rudranshgoel1/litezero/prod/pcb/litezero.csv

Id | Designator | Footprint | Quantity | Designation | Supplier and ref
1 | C1, C3, C5, C10, C12, C13 | C_0805_2012Metric_Pad1.18x1.45mm_HandSolder | 6 | 10uF
2 | C2, C4, C6, C8, C9, C11, C14 | C_0805_2012Metric_Pad1.18x1.45mm_HandSolder | 7 | 100nF
3 | C7 | C_0805_2012Metric_Pad1.18x1.45mm_HandSolder | 1 | 22uF
4 | D1 | LED_D5.0mm | 1 | POWER
5 | D2 | LED_D5.0mm | 1 | STATUS
6 | D3, D4 | LED_D5.0mm | 2 | LED
7 | J1 | PinHeader_1x04_P2.54mm_Vertical | 1 | 1.3 inch
8 | J2 | USB_C_Receptacle_HRO_TYPE-C-31-M-12 | 1 | USB_C_Receptacle_USB2.0_14P
9 | J3, J5 | PinHeader_1x03_P2.54mm_Vertical | 2 | Conn_01x03
10 | J4 | PinHeader_2x04_P2.54mm_Vertical | 1 | cc1101
11 | J7 | PinHeader_1x04_P2.54mm_Vertical | 1 | pn532
12 | J8 | PinHeader_1x06_P2.54mm_Vertical | 1 | sd card reader
13 | Q1 | TO-92_Inline | 1 | 2N3904
14 | R1, R2 | R_0805_2012Metric_Pad1.20x1.40mm_HandSolder | 2 | 220ohm
15 | R3 | R_0805_2012Metric_Pad1.20x1.40mm_HandSolder | 1 | 1k ohm
16 | R4, R5 | R_0805_2012Metric_Pad1.20x1.40mm_HandSolder | 2 | 100 ohm
17 | R6, R7 | R_0805_2012Metric_Pad1.20x1.40mm_HandSolder | 2 | 5.1kohm
18 | R10 | R_0805_2012Metric_Pad1.20x1.40mm_HandSolder | 1 | 10 kohm
19 | SW1 | SW_PUSH_6mm | 1 | UP
20 | SW2 | SW_PUSH_6mm | 1 | DOWN
21 | SW3 | SW_PUSH_6mm | 1 | SELECT
22 | U1, U3 | nRF24L01_Breakout | 2 | NRF24L01_Breakout
23 | U2 | SOT-23-5 | 1 | AP2112K-3.3
24 | U4 | Vishay_MINICAST-3Pin | 1 | TSOP382xx
25 | U6 | ESP32-S3-WROOM-1 | 1 | ESP32-S3-WROOM-1
