rudranshgoel1/litezero/images/litezero.pdf

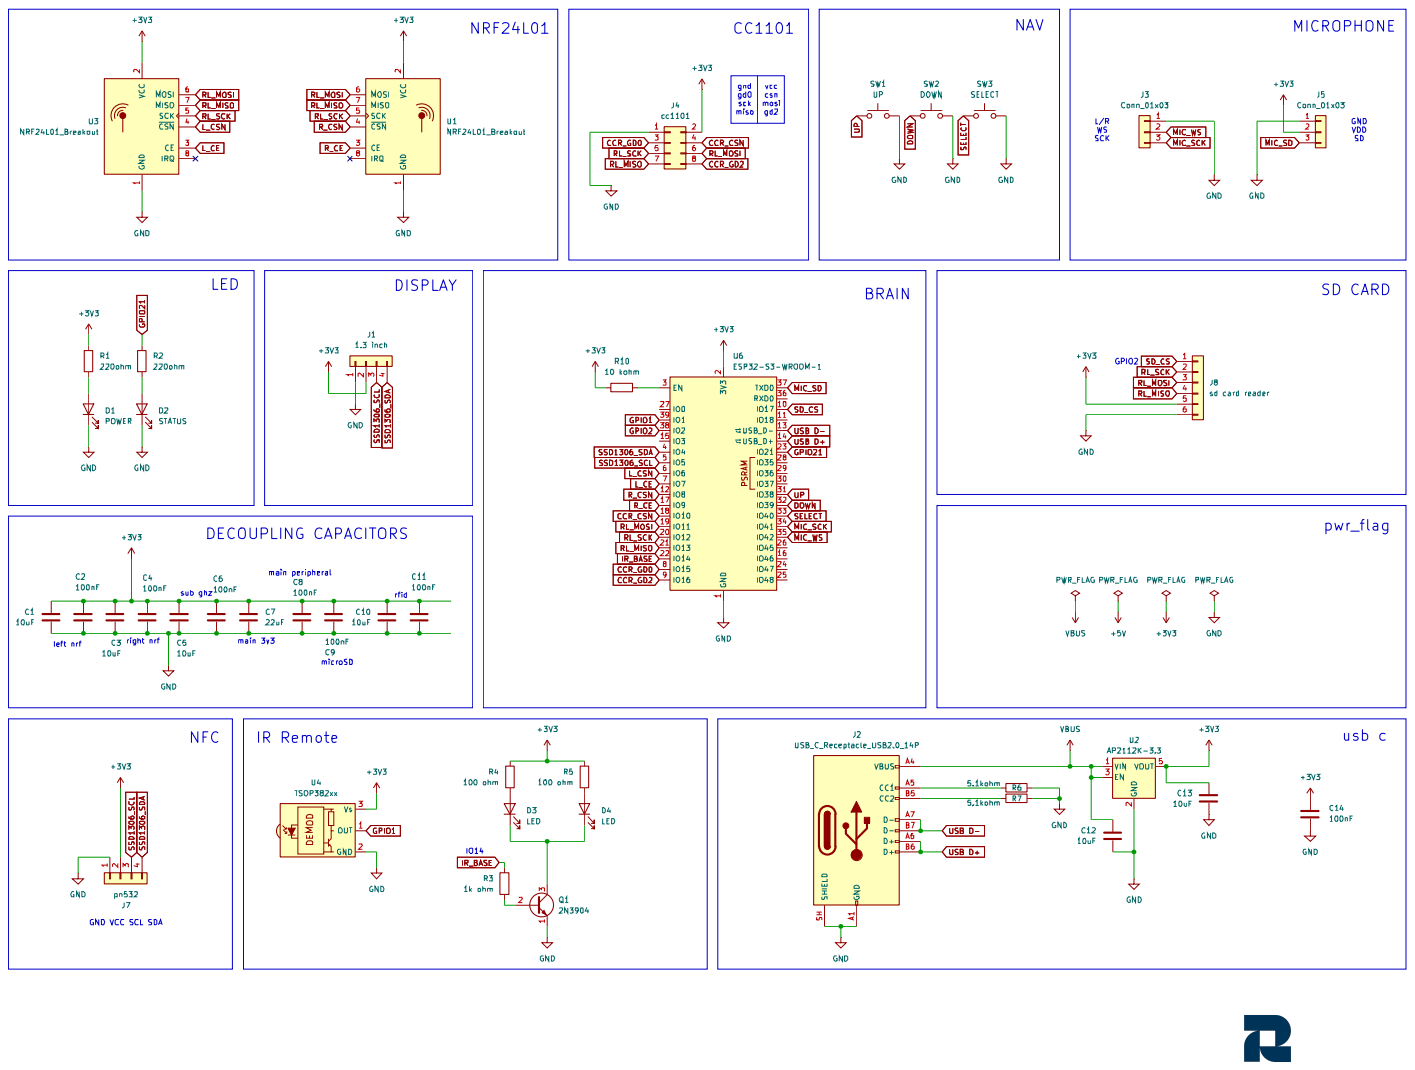
[picture p5: page 1]
