rudranshgoel1/litezero/pcb/litezero.kicad_pcb

## KiCad design pcb/litezero.kicad_pcb (2026-10-13)

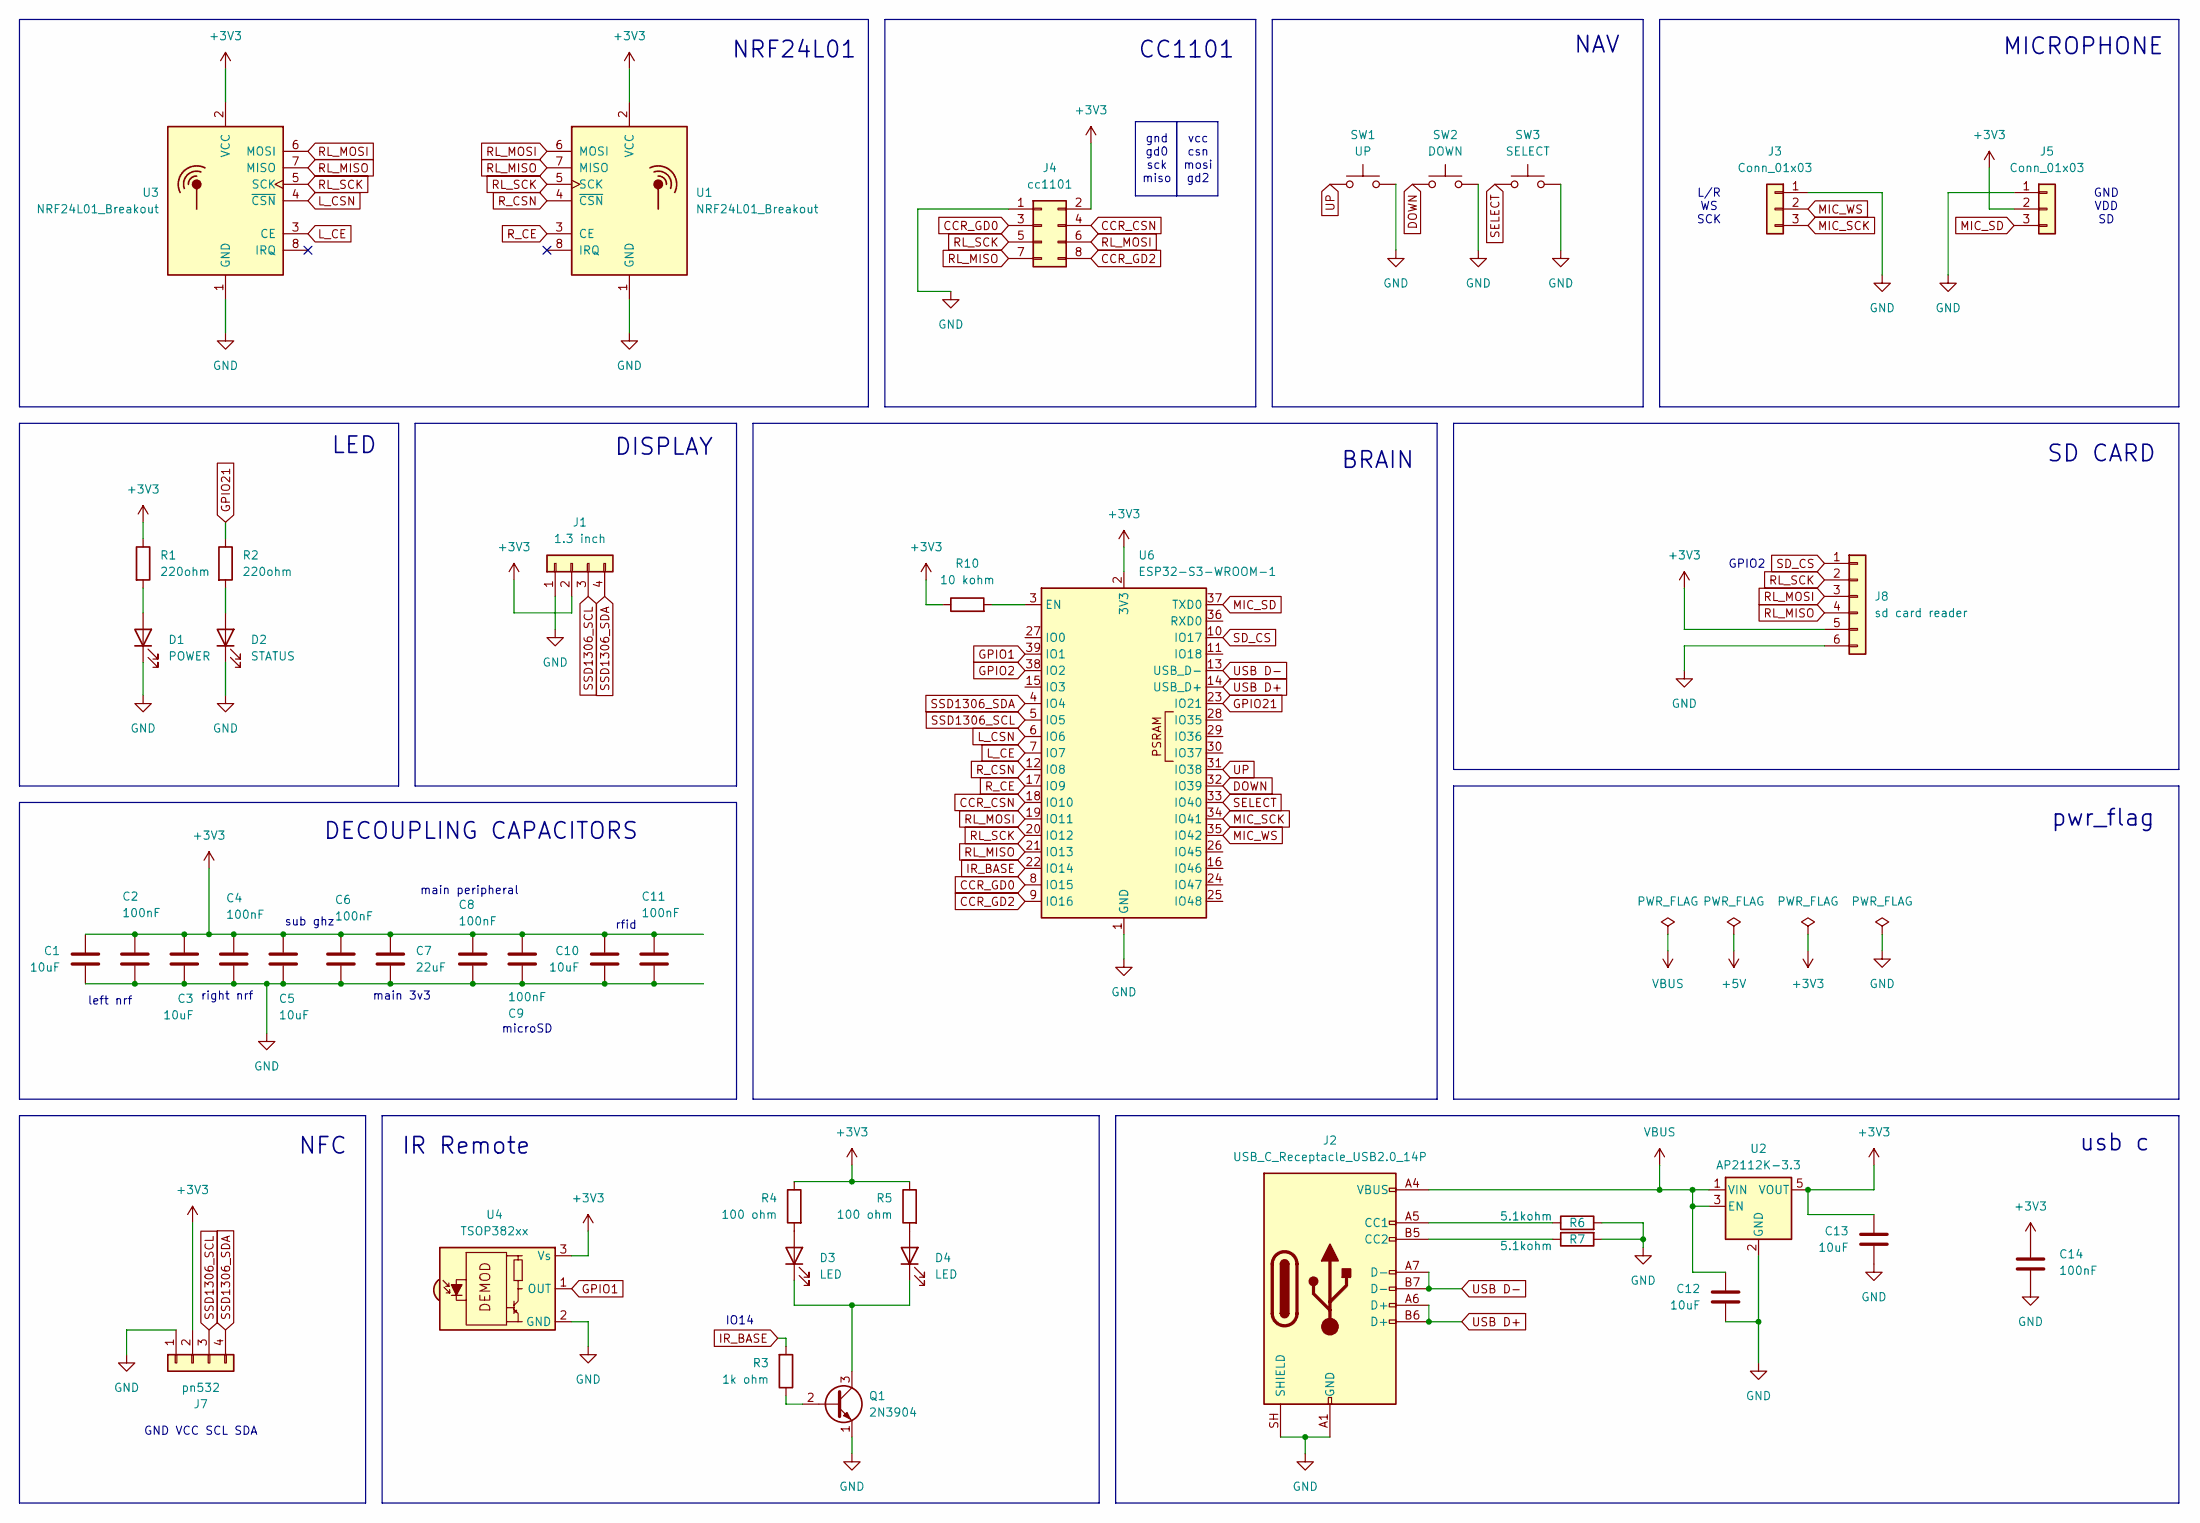
[picture p6: schematic litezero.kicad_sch]

Parts:
C1, C3, C5, C10, C12, C13: 10uF; C_0805_2012Metric_Pad1.18x1.45mm_HandSolder
C2, C4, C6, C8, C9, C11, C14: 100nF; C_0805_2012Metric_Pad1.18x1.45mm_HandSolder
C7: 22uF; C_0805_2012Metric_Pad1.18x1.45mm_HandSolder
D1: POWER; LED_D5.0mm
D2: STATUS; LED_D5.0mm
D3, D4: LED; LED_D5.0mm
J1: 1.3 inch; PinHeader_1x04_P2.54mm_Vertical
J2: USB_C_Receptacle_USB2.0_14P; USB_C_Receptacle_HRO_TYPE-C-31-M-12
J3, J5: Conn_01x03; PinHeader_1x03_P2.54mm_Vertical
J4: cc1101; PinHeader_2x04_P2.54mm_Vertical
J7: pn532; PinHeader_1x04_P2.54mm_Vertical
J8: sd card reader; PinHeader_1x06_P2.54mm_Vertical
Q1: 2N3904; TO-92_Inline
R1, R2: 220ohm; R_0805_2012Metric_Pad1.20x1.40mm_HandSolder
R3: 1k ohm; R_0805_2012Metric_Pad1.20x1.40mm_HandSolder
R4, R5: 100 ohm; R_0805_2012Metric_Pad1.20x1.40mm_HandSolder
R6, R7: 5.1kohm; R_0805_2012Metric_Pad1.20x1.40mm_HandSolder
R10: 10 kohm; R_0805_2012Metric_Pad1.20x1.40mm_HandSolder
SW1: UP; SW_PUSH_6mm
SW2: DOWN; SW_PUSH_6mm
SW3: SELECT; SW_PUSH_6mm
U1, U3: NRF24L01_Breakout; nRF24L01_Breakout
U2: AP2112K-3.3; SOT-23-5
U4: TSOP382xx; Vishay_MINICAST-3Pin
U6: ESP32-S3-WROOM-1

Connections:
+3V3: C1.1, C2.1, C3.1, C4.1, C5.1, C6.1, C7.1, C8.1, C9.2, C10.1, C11.1, C13.1, C14.1, J1.2, J4.2, J5.2, J7.2, J8.5, R1.1, R4.1, R5.1, R10.1, U1.2 (VCC), U2.5 (VOUT), U3.2 (VCC), U4.3 (Vs), U6.2 (3V3)
CCR_CSN: J4.4, U6.18 (IO10)
CCR_GD0: J4.3, U6.8 (IO15)
CCR_GD2: J4.8, U6.9 (IO16)
DOWN: SW2.1, U6.32 (IO39)
GND: C1.2, C2.2, C3.2, C4.2, C5.2, C6.2, C7.2, C8.2, C9.1, C10.2, C11.2, C12.2, C13.2, C14.2, D1.1 (K), D2.1 (K), J1.1, J2.A1 (GND), J2.A12 (GND), J2.B1 (GND), J2.B12 (GND), J2.SH (SHIELD), J3.1, J4.1, J5.1, J7.1, J8.6, Q1.1 (E), R6.2, R7.2, SW1.2, SW2.2, SW3.2, U1.1 (GND), U2.2 (GND), U3.1 (GND), U4.2 (GND), U6.1 (GND), U6.40 (GND), U6.41 (GND)
GPIO1: U4.1 (OUT), U6.39 (IO1)
GPIO2: U6.38 (IO2)
GPIO21: R2.1, U6.23 (IO21)
IR_BASE: R3.2, U6.22 (IO14)
L_CE: U3.3 (CE), U6.7 (IO7)
L_CSN: U3.4 (~CSN), U6.6 (IO6)
MIC_SCK: J3.3, U6.34 (IO41)
MIC_SD: J5.3, U6.37 (TXD0)
MIC_WS: J3.2, U6.35 (IO42)
unnamed: D1.2 (A), R1.2
unnamed: D2.2 (A), R2.2
unnamed: D3.2 (A), R4.2
unnamed: D3.1 (K), D4.1 (K), Q1.3 (C)
unnamed: D4.2 (A), R5.2
unnamed: J2.A5 (CC1), R6.1
unnamed: J2.B5 (CC2), R7.1
unnamed: Q1.2 (B), R3.1
unnamed: R10.2, U6.3 (EN)
RL_MISO: J4.7, J8.4, U1.7 (MISO), U3.7 (MISO), U6.21 (IO13)
RL_MOSI: J4.6, J8.3, U1.6 (MOSI), U3.6 (MOSI), U6.19 (IO11)
RL_SCK: J4.5, J8.2, U1.5 (SCK), U3.5 (SCK), U6.20 (IO12)
R_CE: U1.3 (CE), U6.17 (IO9)
R_CSN: U1.4 (~CSN), U6.12 (IO8)
SD_CS: J8.1, U6.10 (IO17)
SELECT: SW3.1, U6.33 (IO40)
SSD1306_SCL: J1.3, J7.3, U6.5 (IO5)
SSD1306_SDA: J1.4, J7.4, U6.4 (IO4)
UP: SW1.1, U6.31 (IO38)
USB D+: J2.A6 (D+), J2.B6 (D+), U6.14 (USB_D+)
USB D-: J2.A7 (D-), J2.B7 (D-), U6.13 (USB_D-)
VBUS: C12.1, J2.A4 (VBUS), J2.A9 (VBUS), J2.B4 (VBUS), J2.B9 (VBUS), U2.1 (VIN), U2.3 (EN)

Notes on the sheet:
gnd gd0 sck miso
rfid
DECOUPLING CAPACITORS
NAV
MICROPHONE
sub ghz
CC1101
NRF24L01
right nrf
LED
IR Remote
NFC
GPIO2
DISPLAY
vcc csn mosi gd2
main peripheral
BRAIN
main 3v3
pwr_flag
GND VCC SCL SDA
GND VDD SD
L/R WS SCK
left nrf
usb c
IO14
microSD
SD CARD

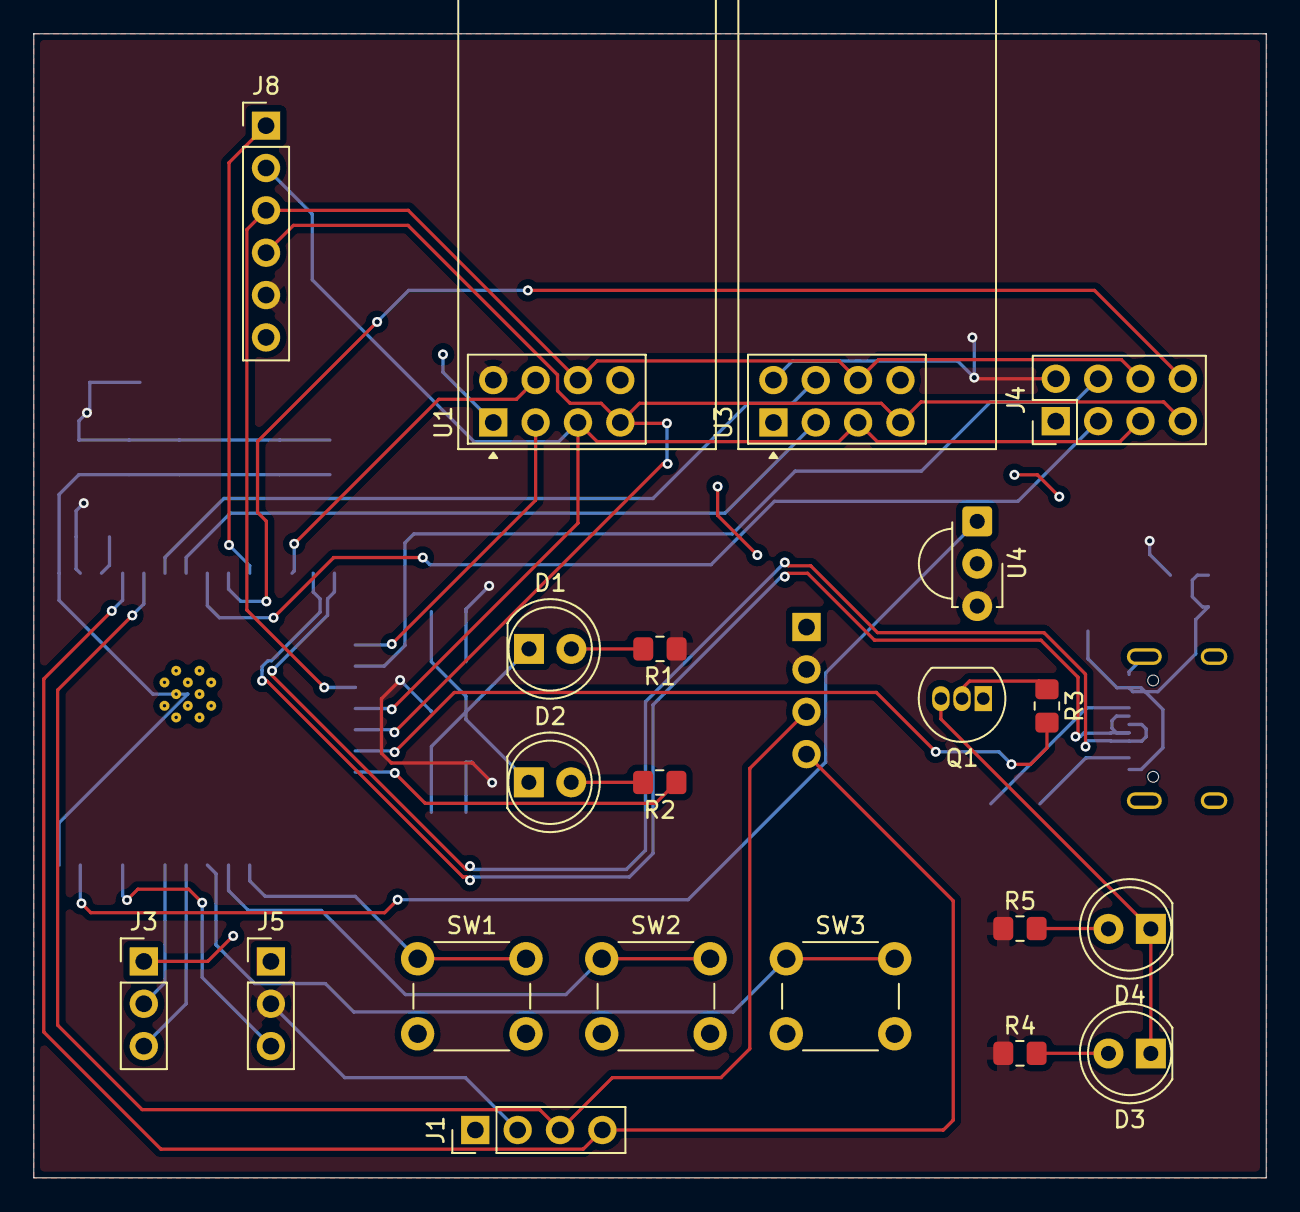
[picture p7: board litezero.kicad_pcb from above]

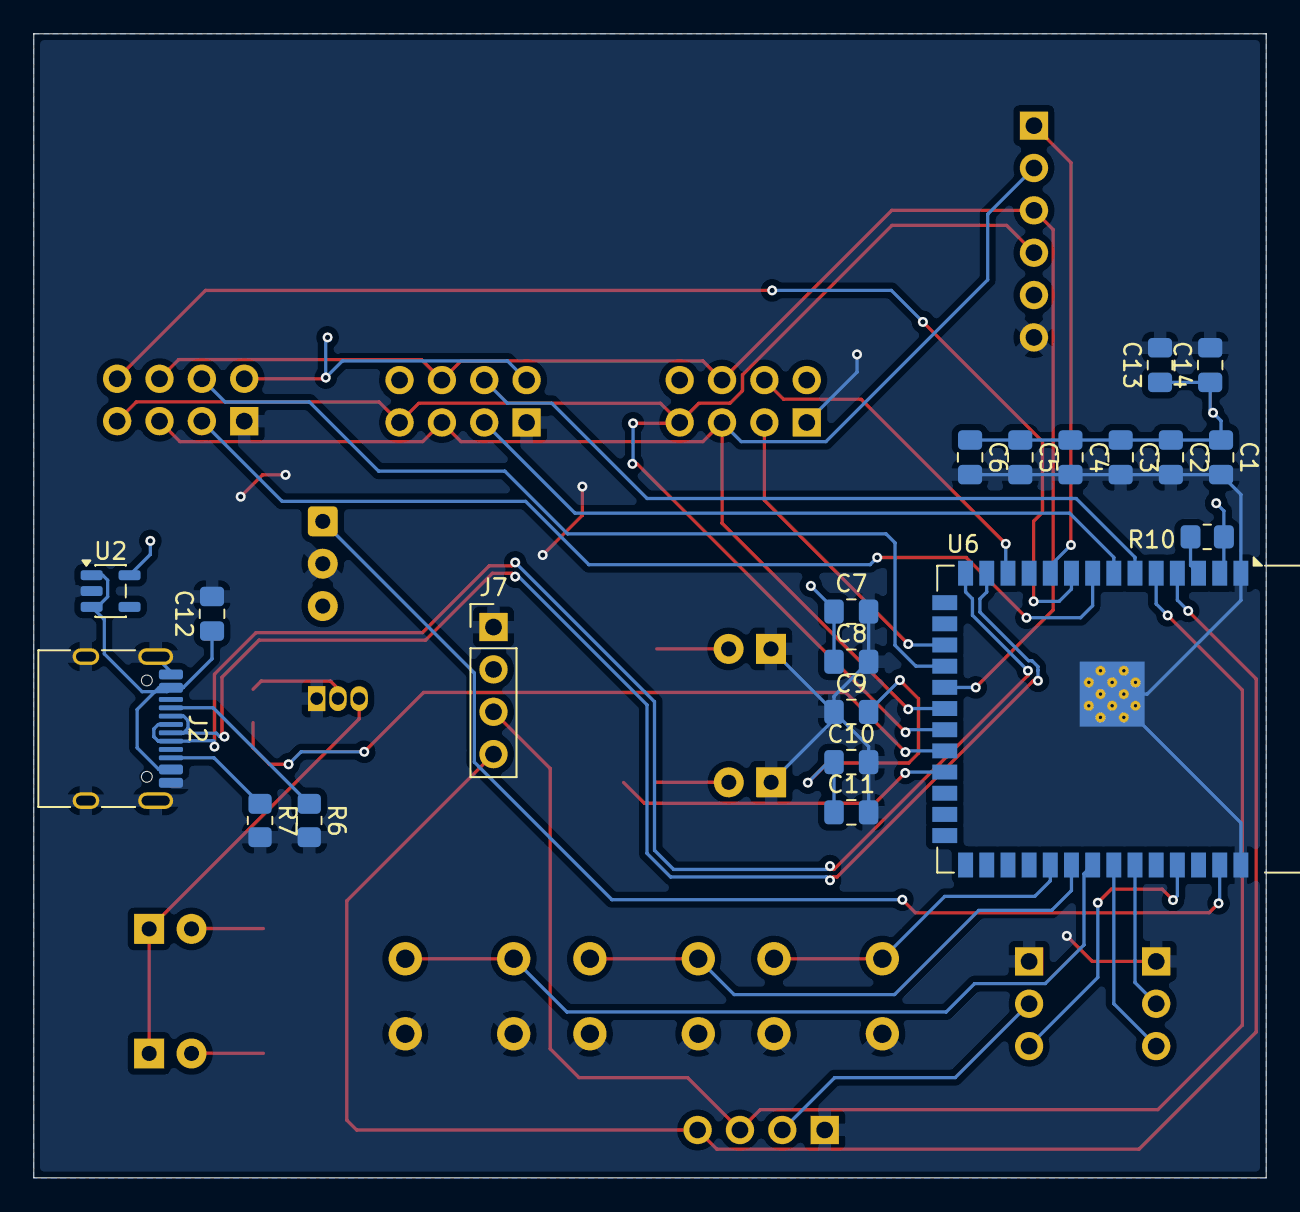
[picture p8: board litezero.kicad_pcb from below]

Board: 2 copper layers, 73.9 x 68.6 mm, 42 parts (21 on the bottom side), 36 nets.
